shujima/thin-c-lock/README.md

## Overview / 概要

thin-C-lock is a clock style interior decoration which use thin PCB design technology developped by shujima 
thin-C-lockは shujima の薄型基板開発技術を活用して作られた時計風インテリアです。

お問合せはX(twitter) : @shjma_のDM等にお願いします。

[デザフェスtype-C-lock説明書.pdf](https://github.com/user-attachments/files/15746385/type-C-lock.1.pdf)

## Usage / 使い方


### Normal operation / 通常動作中

|Button|Function|
|-|-|
|Up button / 下ボタン| Color change / 色の変更・秒針表示の変更|
|Down button / 下ボタン| Color change / 色の変更・秒針表示の変更|
|Set button / 設定ボタン| Enter time setting mode / 時刻設定モード |

In v1.0.0 firmware, color of the hands and second display style have 7 x 3 = 21 styles.
v1.0.0のファームウェアにおいては、針の色と秒針のスタイルの設定は 7 x 3 = 21種類あります。

### Time setting mode / 時刻設定モード

時刻設定モードではまず時間（短針）の時間を変えることができます。

|Button|Function|
|-|-|
|Up button / 下ボタン| Change Time / 時刻変更|
|Down button / 下ボタン| Change Time / 時刻変更|
|Set button / 設定ボタン| To long hand setting / 長針設定へ |

長針設定モードも操作は同様です。

|Button|Function|
|-|-|
|Up button / 下ボタン| Change Time / 時刻変更|
|Down button / 下ボタン| Change Time / 時刻変更|
|Set button / 設定ボタン| Back to normal operation / 通常動作へ |

## Open source-data and usage / データの公開および利用
基板データ（BOM含む）とファームウェアを共に公開しています。
公序良俗に反しない範囲で自由にお使いいただけます。

* PCB data / 基板データ
https://github.com/shujima/thin-c-lock/releases
* USB Type-C like connector library for KiCAD / USB Type-C風コネクタ部位のみ(KiCAD用ライブラリ)
https://github.com/shujima/type-c-card/tree/master/hardware/lib_usb-type-c
* Firmware / ファームウェア
https://github.com/shujima/thin-c-lock-firmware

## Firmware update / ファームウェアアップデート

### Overview / 概要

thin-C-lock can update the firmware via Windows PC.
thin-C-lockはWindows PCを利用したファームウェアアップデートが可能です。

### Caution / 注意
* Firmware Update process is delete all internal data of thin-C-lcok and install new program file.
* If we make any misstake at this Firmware Update process, thin-C-lock may no longer work.
* Need Windows PC.
* ファームウェアアップデートはthin-C-lock内部のデータをすべて削除して、新しいプログラムファイルをインストールする作業です。
* ファームウェアアップデートの手順を間違えたりするとthin-C-lockが動作しなくなる恐れがあります。
* WindowsのPCが必要です。

### 1. ファームウェアのダウンロード

Open below link.
以下のリンクを開いてください。
[https://github.com/shujima/thin-c-lock-firmware]

Open "Releases"
"Releases"を開いてください。


Click and download the ".hex" file on the version which you want (v1.0.0 on this image).
ダウンロードしたいバージョン（この画像はv1.0.0）の欄にある".hex"で終わるファイルをクリックしてダウンロードしてください。


### 2. ファームウェア書き込みツールのインストール
Open below link (Chinese chip manufacturer).
以下のリンク（中国のチップメーカーのサイト）を開いてください。
[https://www.wch.cn/download/WCHISPTool_Setup_exe.html]

Click"下載" (means download) then it will start the download.
以下の"下載"（ダウンロードの意）をクリックしてダウンロードしてください。


インストール作業を行ってください。

### 3.  ファームウェア書き込みツールを開く
インストールしたファームウェア書き込みツール"WCHISPStudio"を開いてください。


Click ... button
「...」を押してください


Select ".hex" file downloaded on the step 1 and select "Open".
Step 1でダウンロードした「.hex」で終わるファイルを選択して「開く」を押してください。


### 4. 本体を準備する
Please remove thin-C-lock from thin-C-base and insert designated USB Type-C cable to thin-C-lock.
Do not insert to PC yet.
thin-C-lock本体をthin-C-baseから取り外して、thin-C-lockに付属のUSB Type-Cケーブルを差し込んでください。
まだPCには接続しないでください。


Do step 3 if you didn't yet, open and prepare WCHISPStudio.
まだやっていない場合は、Step 3を行って、WCHISPStudioを開いて準備しておいてください。


Insert the USB cable to your PC while pushing long the button for the Firmware Update which on near the center on thin-C-lock.
thin-C-lock本体の中央付近にあるファームウェアアップデート用ボタンを長押ししながら、USBケーブルの反対側をPCに挿入してください。


#### if successed / 成功例

All LEDs on thin-C-lock should don't lit. 
And can see green strings on WCHISPStudio.
成功するとthin-C-lockは一切LEDなどが点灯しなくなります。
またWCIHSPStudio上に緑色の文字列が表示されます。
IMG_6361 (1)


#### if failed / 失敗例

Any LED/s on thin-C-lock lit. 
文字盤を含むthin-C-lockのいずれかのLEDが点灯します。
IMG_6367 (1)

### 5. 書き込み操作をする

Re-check the configlation.
設定を再度確認します。


Click Download button.
"Download"ボタンを押します。


Re-start thin-C-lock when succeed.
You can remove USB cable and bring back thin-C-lock.
thin-C-lockが動作を再開すれば成功です。
そのままUSBケーブルを抜いてthin-C-lockを元に戻します。
