shujima/thin-c-lock/thin-c-lock_80/pcb/sub_LED.kicad_sch

## KiCad design thin-c-lock_80/pcb/sub_LED.kicad_sch (2024-05-26)

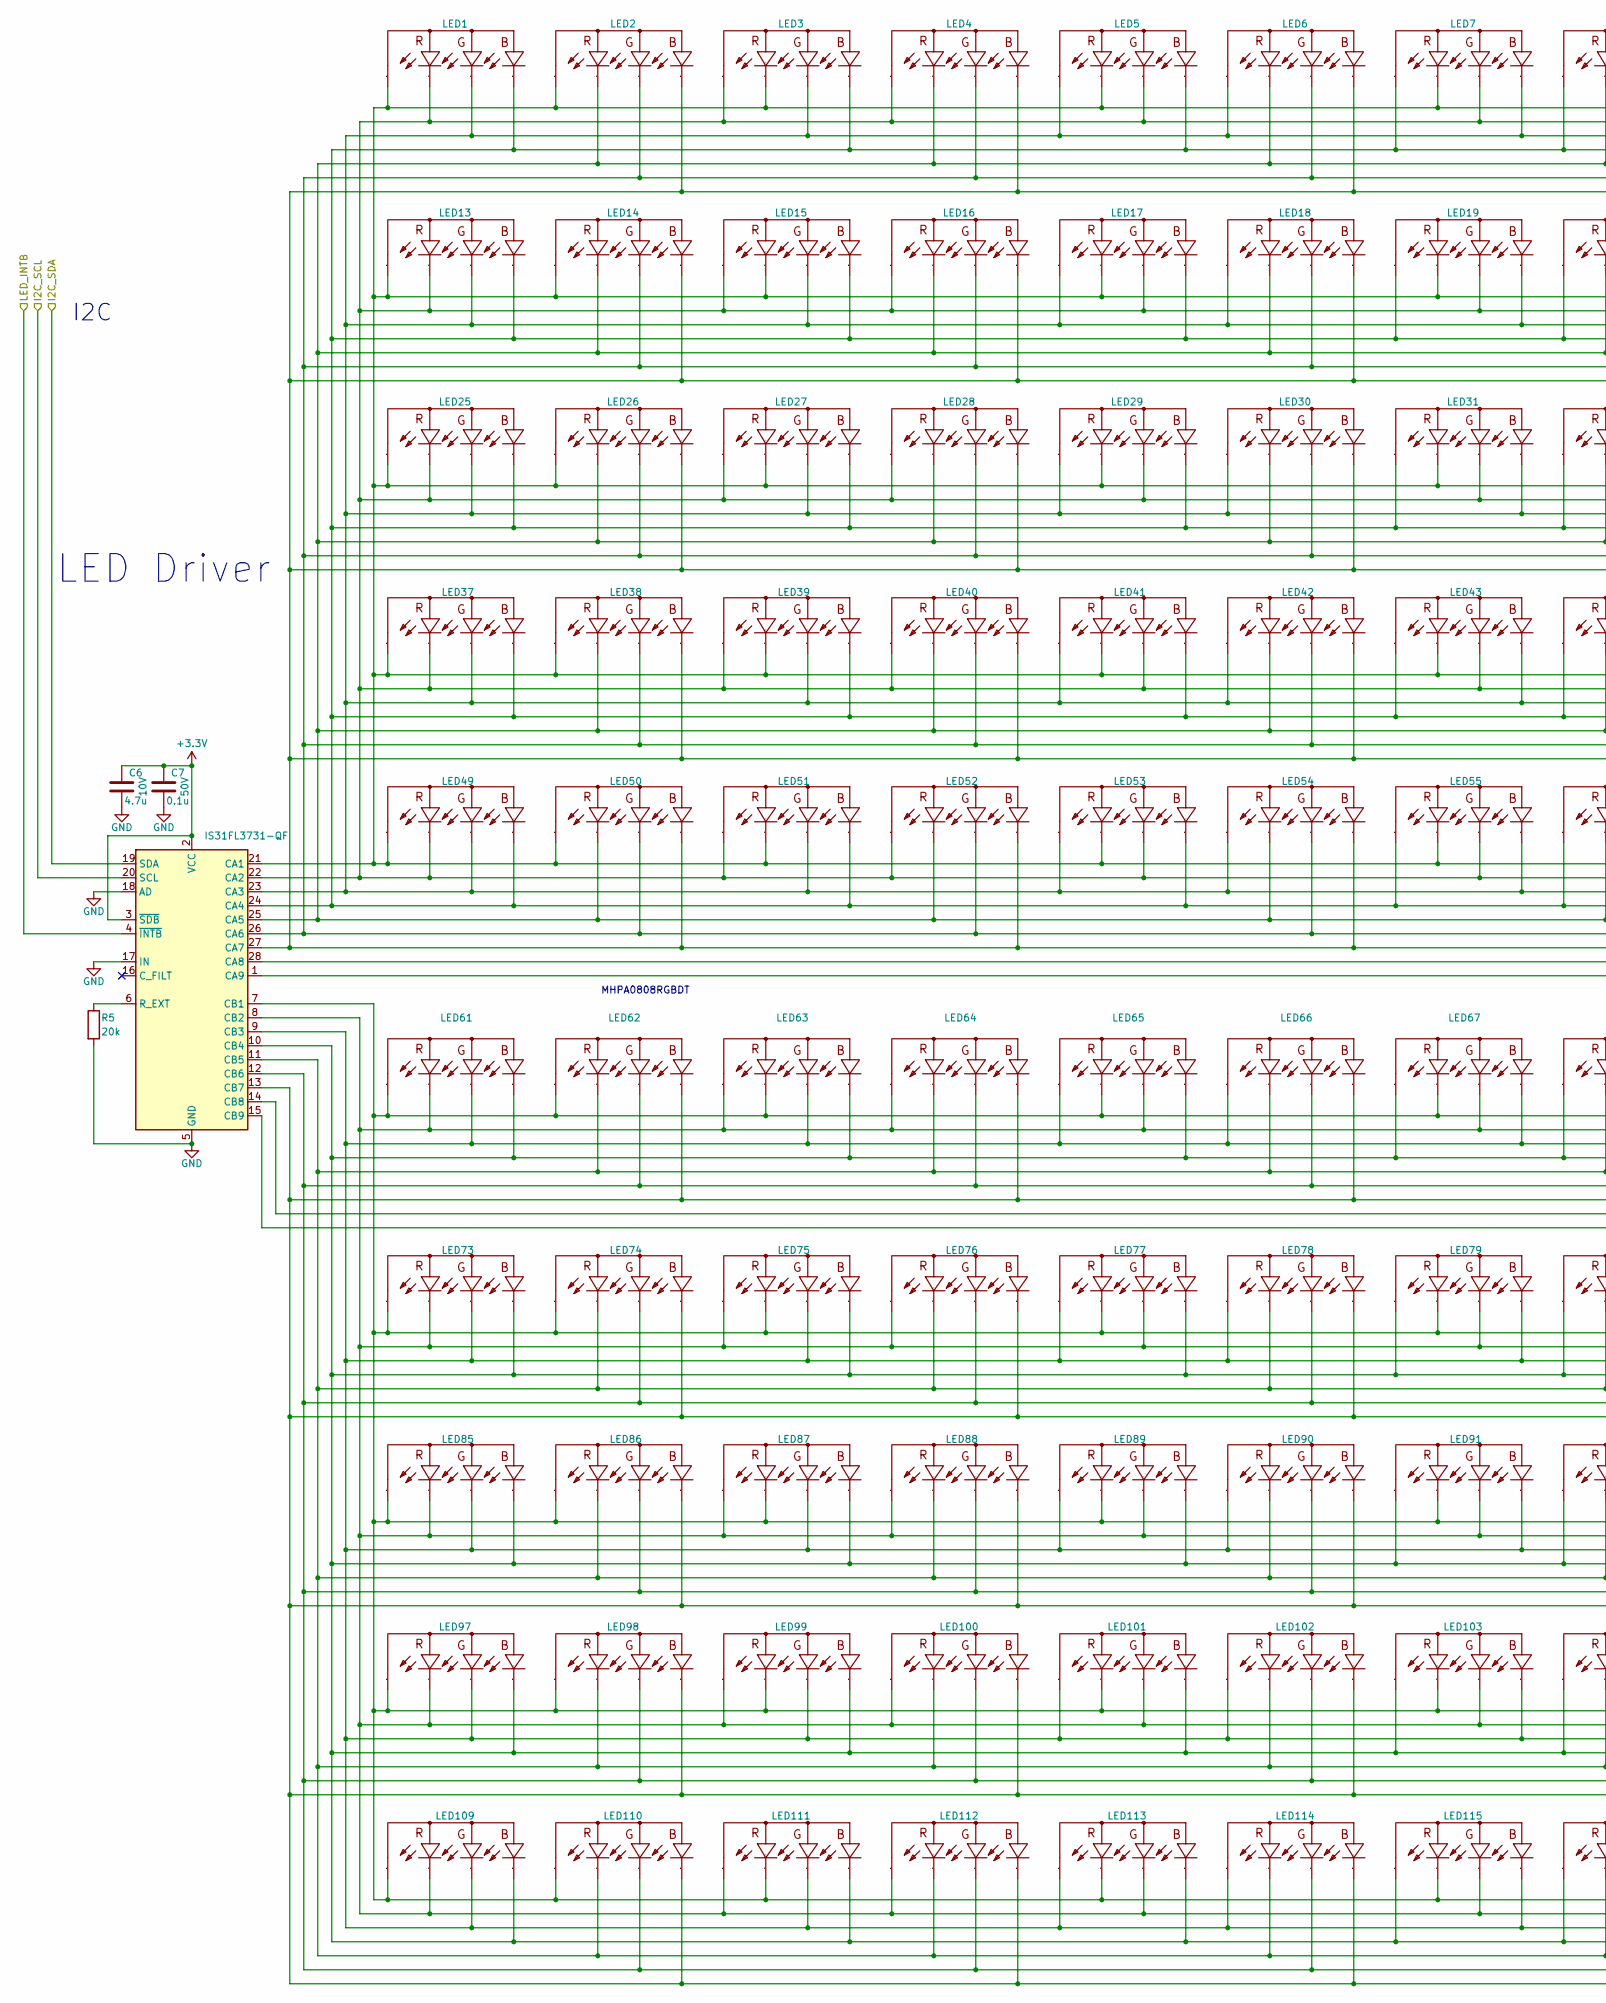
[picture p1: schematic sub_LED.kicad_sch, part in row 1, column 1]

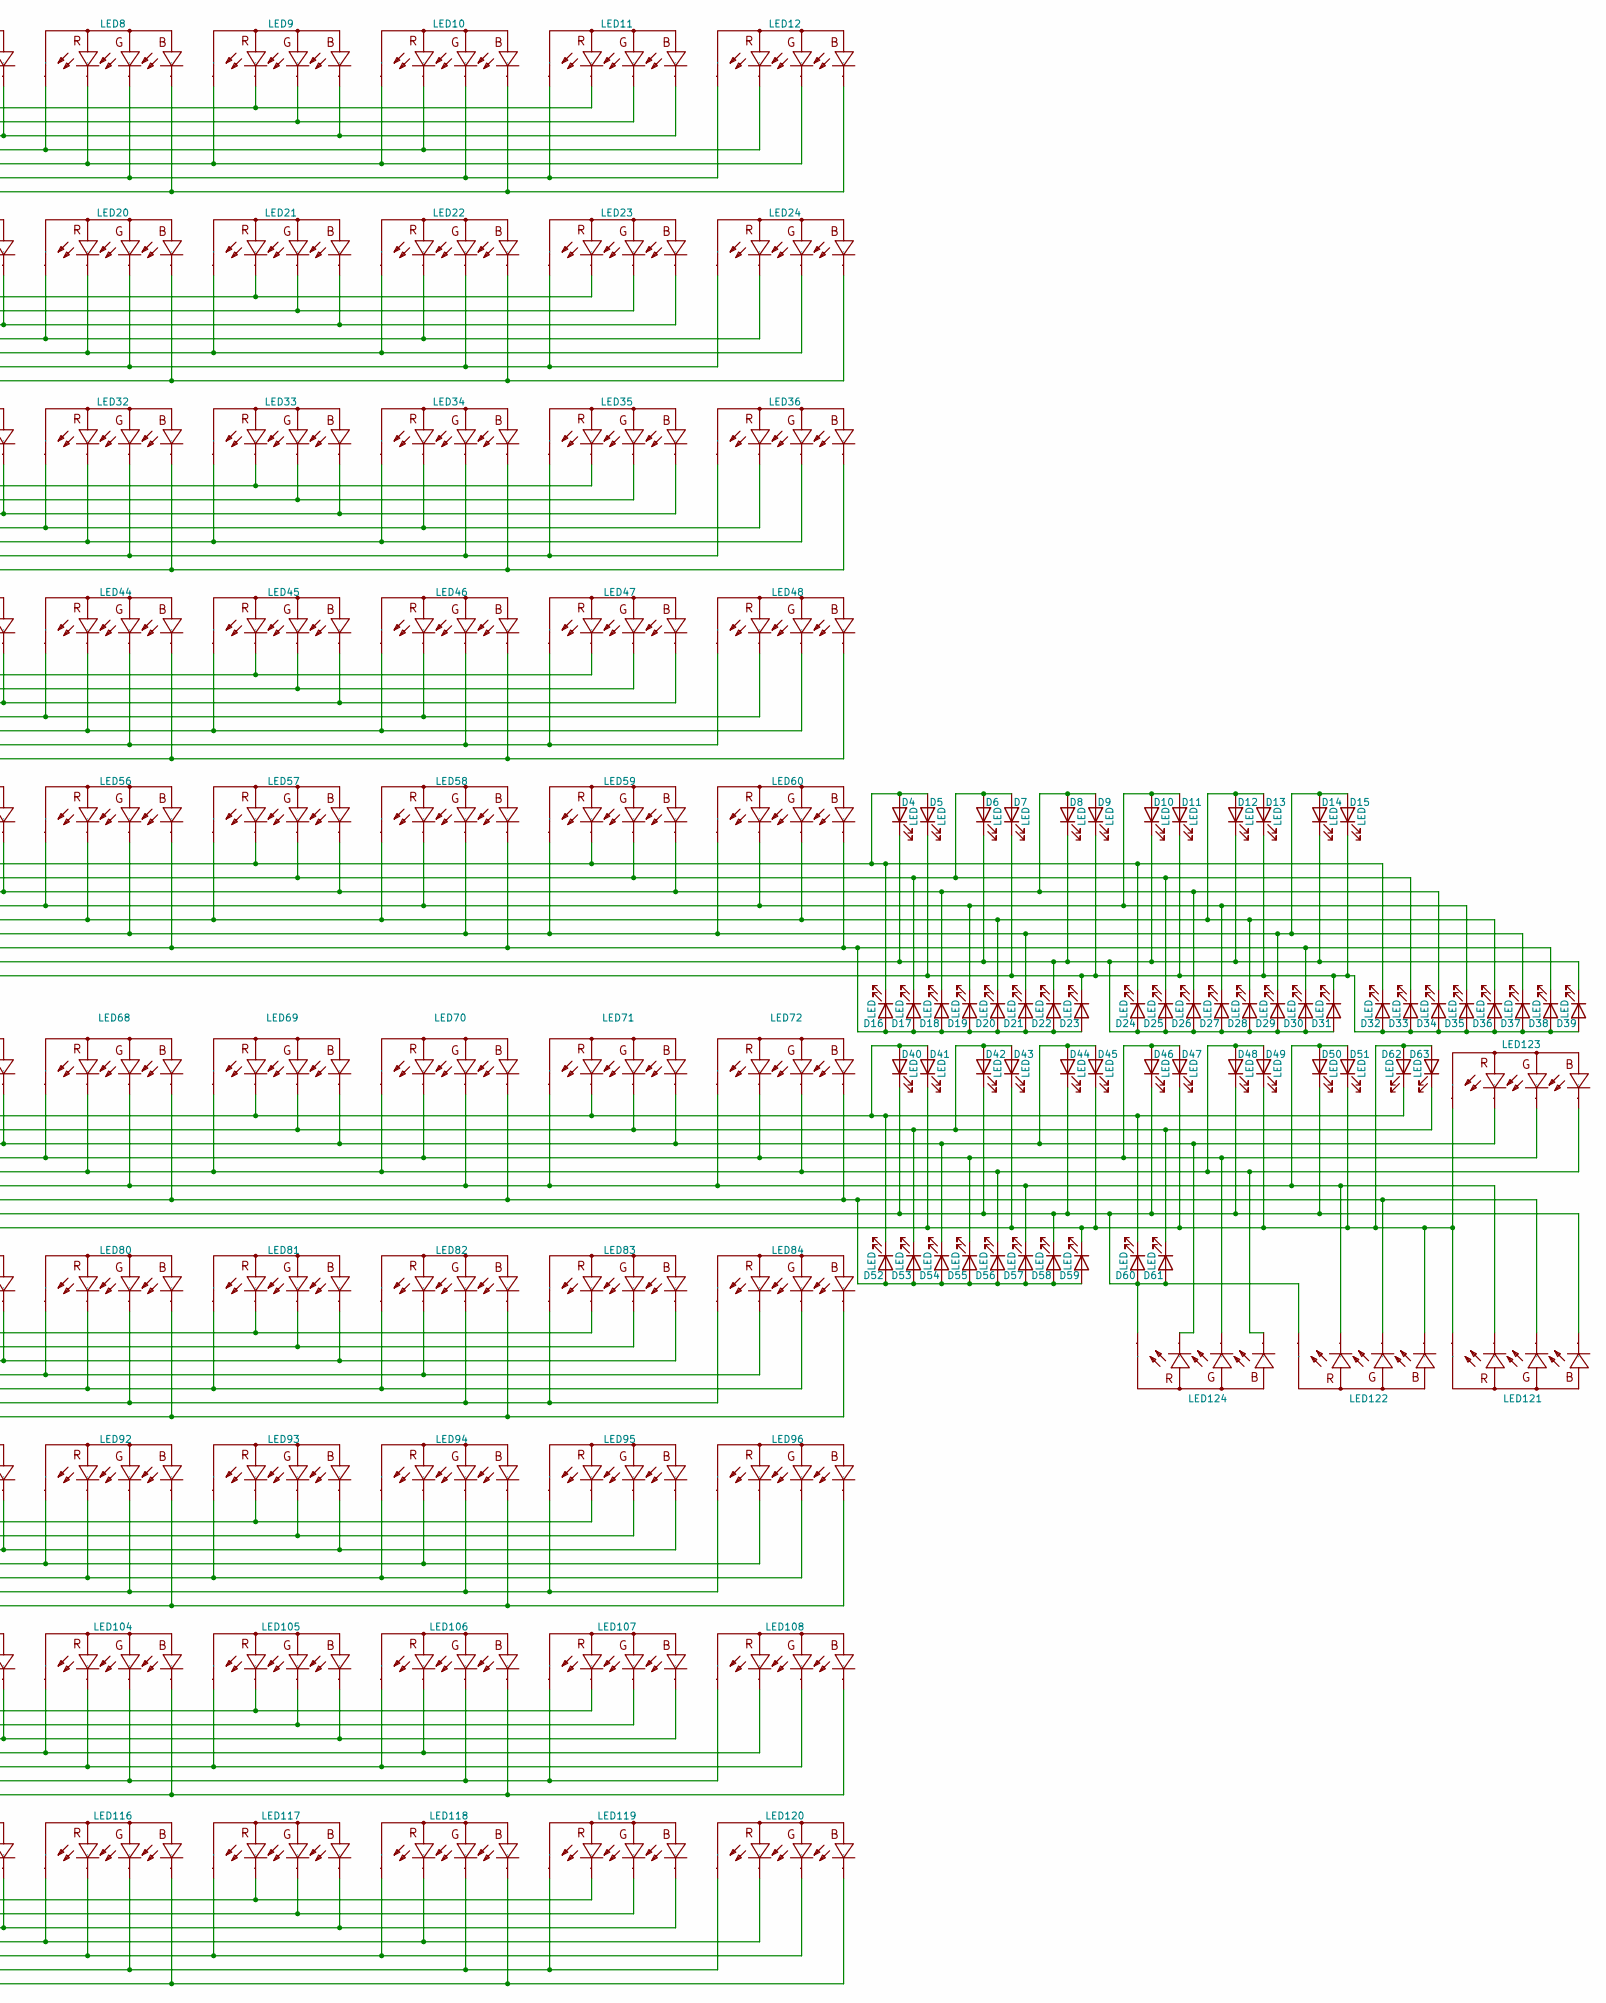
[picture p2: schematic sub_LED.kicad_sch, part in row 1, column 2]

Parts:
C6: 4.7u; C_0402_1005Metric; MPN CL05A475MP5NRNC; LCSC C23733
C7: 0.1u; C_0402_1005Metric; MPN CL05B104KB54PNC; LCSC C307331
D4, D5, D6, D7, D8, D9, D10, D11, D12, D13, D14, D15, D16, D17, D18, D19, D20, D21, D22, D23, D24, D25, D26, D27, D28, D29, D30, D31, D32, D33, D34, D35, D36, D37, D38, D39, D40, D41, D42, D43, D44, D45, D46, D47, D48, D49, D50, D51, D52, D53, D54, D55, D56, D57, D58, D59, D60, D61, D62, D63: LED; LED_0603_1608Metric; MPN KT-0603W; LCSC C2290
LED1, LED2, LED3, LED4, LED5, LED6, LED7, LED8, LED9, LED10, LED11, LED12, LED13, LED14, LED15, LED16, LED17, LED18, LED19, LED20, LED21, LED22, LED23, LED24, LED25, LED26, LED27, LED28, LED29, LED30, LED31, LED32, LED33, LED34, LED35, LED36, LED37, LED38, LED39, LED40, LED41, LED42, LED43, LED44, LED45, LED46, LED47, LED48, LED49, LED50, LED51, LED52, LED53, LED54, LED55, LED56, LED57, LED58, LED59, LED60, LED61, LED62, LED63, LED64, LED65, LED66, LED67, LED68, LED69, LED70, LED71, LED72, LED73, LED74, LED75, LED76, LED77, LED78, LED79, LED80, LED81, LED82, LED83, LED84, LED85, LED86, LED87, LED88, LED89, LED90, LED91, LED92, LED93, LED94, LED95, LED96, LED97, LED98, LED99, LED100, LED101, LED102, LED103, LED104, LED105, LED106, LED107, LED108, LED109, LED110, LED111, LED112, LED113, LED114, LED115, LED116, LED117, LED118, LED119, LED120, LED121, LED122, LED123, LED124: LED-ARRAY-SMD_4P-L0.80-W0.80-BR; MPN MHPA0808RGBDT; LCSC C404279
R5: 20k; R_0402_1005Metric; MPN 0402WGF2002TCE; LCSC C25765
U2: IS31FL3731-QF; QFN-28-1EP_4x4mm_P0.4mm_EP2.3x2.3mm; MPN IS31FL3731-QFLS2-TR; LCSC C191206

Connections:
+3.3V: C6.1, C7.1, U2.2 (VCC), U2.3 (~SDB)
GND: C6.2, C7.2, R5.2, U2.5 (GND), U2.17 (IN), U2.18 (AD), U2.29 (GND)
I2C_SCL: U2.20 (SCL)
I2C_SDA: U2.19 (SDA)
LED_INTB: U2.4 (~INTB)
unnamed: D4.1 (K), D6.1 (K), D8.1 (K), D10.1 (K), D12.1 (K), D14.1 (K), D22.1 (K), D24.2 (A), D25.2 (A), D26.2 (A), D27.2 (A), D28.2 (A), D29.2 (A), D30.2 (A), D31.2 (A), D39.1 (K), U2.28 (CA8)
unnamed: D10.2 (A), D11.2 (A), D19.1 (K), D27.1 (K), D35.1 (K), LED1.4 (-), LED3.4 (-), LED5.4 (-), LED7.1 (+), LED8.1 (+), LED10.2 (-), LED12.2 (-), LED13.4 (-), LED15.4 (-), LED17.4 (-), LED19.1 (+), LED20.1 (+), LED22.2 (-), LED24.2 (-), LED25.4 (-), LED27.4 (-), LED29.4 (-), LED31.1 (+), LED32.1 (+), LED34.2 (-), LED36.2 (-), LED37.4 (-), LED39.4 (-), LED41.4 (-), LED43.1 (+), LED44.1 (+), LED46.2 (-), LED48.2 (-), LED49.4 (-), LED51.4 (-), LED53.4 (-), LED55.1 (+), LED56.1 (+), LED58.2 (-), LED60.2 (-), U2.24 (CA4)
unnamed: D5.1 (K), D7.1 (K), D9.1 (K), D11.1 (K), D13.1 (K), D15.1 (K), D23.1 (K), D31.1 (K), D32.2 (A), D33.2 (A), D34.2 (A), D35.2 (A), D36.2 (A), D37.2 (A), D38.2 (A), D39.2 (A), U2.1 (CA9)
unnamed: D12.2 (A), D13.2 (A), D20.1 (K), D28.1 (K), D36.1 (K), LED2.2 (-), LED4.2 (-), LED6.2 (-), LED8.2 (-), LED9.1 (+), LED10.1 (+), LED12.3 (-), LED14.2 (-), LED16.2 (-), LED18.2 (-), LED20.2 (-), LED21.1 (+), LED22.1 (+), LED24.3 (-), LED26.2 (-), LED28.2 (-), LED30.2 (-), LED32.2 (-), LED33.1 (+), LED34.1 (+), LED36.3 (-), LED38.2 (-), LED40.2 (-), LED42.2 (-), LED44.2 (-), LED45.1 (+), LED46.1 (+), LED48.3 (-), LED50.2 (-), LED52.2 (-), LED54.2 (-), LED56.2 (-), LED57.1 (+), LED58.1 (+), LED60.3 (-), U2.25 (CA5)
unnamed: D14.2 (A), D15.2 (A), D21.1 (K), D29.1 (K), D37.1 (K), LED2.3 (-), LED4.3 (-), LED6.3 (-), LED8.3 (-), LED10.3 (-), LED11.1 (+), LED12.1 (+), LED14.3 (-), LED16.3 (-), LED18.3 (-), LED20.3 (-), LED22.3 (-), LED23.1 (+), LED24.1 (+), LED26.3 (-), LED28.3 (-), LED30.3 (-), LED32.3 (-), LED34.3 (-), LED35.1 (+), LED36.1 (+), LED38.3 (-), LED40.3 (-), LED42.3 (-), LED44.3 (-), LED46.3 (-), LED47.1 (+), LED48.1 (+), LED50.3 (-), LED52.3 (-), LED54.3 (-), LED56.3 (-), LED58.3 (-), LED59.1 (+), LED60.1 (+), U2.26 (CA6)
unnamed: D4.2 (A), D5.2 (A), D16.1 (K), D24.1 (K), D32.1 (K), LED1.1 (+), LED2.1 (+), LED3.2 (-), LED5.2 (-), LED7.2 (-), LED9.2 (-), LED11.2 (-), LED13.1 (+), LED14.1 (+), LED15.2 (-), LED17.2 (-), LED19.2 (-), LED21.2 (-), LED23.2 (-), LED25.1 (+), LED26.1 (+), LED27.2 (-), LED29.2 (-), LED31.2 (-), LED33.2 (-), LED35.2 (-), LED37.1 (+), LED38.1 (+), LED39.2 (-), LED41.2 (-), LED43.2 (-), LED45.2 (-), LED47.2 (-), LED49.1 (+), LED50.1 (+), LED51.2 (-), LED53.2 (-), LED55.2 (-), LED57.2 (-), LED59.2 (-), U2.21 (CA1)
unnamed: D16.2 (A), D17.2 (A), D18.2 (A), D19.2 (A), D20.2 (A), D21.2 (A), D22.2 (A), D23.2 (A), D30.1 (K), D38.1 (K), LED2.4 (-), LED4.4 (-), LED6.4 (-), LED8.4 (-), LED10.4 (-), LED12.4 (-), LED14.4 (-), LED16.4 (-), LED18.4 (-), LED20.4 (-), LED22.4 (-), LED24.4 (-), LED26.4 (-), LED28.4 (-), LED30.4 (-), LED32.4 (-), LED34.4 (-), LED36.4 (-), LED38.4 (-), LED40.4 (-), LED42.4 (-), LED44.4 (-), LED46.4 (-), LED48.4 (-), LED50.4 (-), LED52.4 (-), LED54.4 (-), LED56.4 (-), LED58.4 (-), LED60.4 (-), U2.27 (CA7)
unnamed: D6.2 (A), D7.2 (A), D17.1 (K), D25.1 (K), D33.1 (K), LED1.2 (-), LED3.1 (+), LED4.1 (+), LED5.3 (-), LED7.3 (-), LED9.3 (-), LED11.3 (-), LED13.2 (-), LED15.1 (+), LED16.1 (+), LED17.3 (-), LED19.3 (-), LED21.3 (-), LED23.3 (-), LED25.2 (-), LED27.1 (+), LED28.1 (+), LED29.3 (-), LED31.3 (-), LED33.3 (-), LED35.3 (-), LED37.2 (-), LED39.1 (+), LED40.1 (+), LED41.3 (-), LED43.3 (-), LED45.3 (-), LED47.3 (-), LED49.2 (-), LED51.1 (+), LED52.1 (+), LED53.3 (-), LED55.3 (-), LED57.3 (-), LED59.3 (-), U2.22 (CA2)
unnamed: D8.2 (A), D9.2 (A), D18.1 (K), D26.1 (K), D34.1 (K), LED1.3 (-), LED3.3 (-), LED5.1 (+), LED6.1 (+), LED7.4 (-), LED9.4 (-), LED11.4 (-), LED13.3 (-), LED15.3 (-), LED17.1 (+), LED18.1 (+), LED19.4 (-), LED21.4 (-), LED23.4 (-), LED25.3 (-), LED27.3 (-), LED29.1 (+), LED30.1 (+), LED31.4 (-), LED33.4 (-), LED35.4 (-), LED37.3 (-), LED39.3 (-), LED41.1 (+), LED42.1 (+), LED43.4 (-), LED45.4 (-), LED47.4 (-), LED49.3 (-), LED51.3 (-), LED53.1 (+), LED54.1 (+), LED55.4 (-), LED57.4 (-), LED59.4 (-), U2.23 (CA3)
unnamed: D40.1 (K), D42.1 (K), D44.1 (K), D46.1 (K), D48.1 (K), D50.1 (K), D58.1 (K), D60.2 (A), D61.2 (A), LED121.4 (-), LED122.1 (+), LED124.1 (+), U2.14 (CB8)
unnamed: D40.2 (A), D41.2 (A), D52.1 (K), D60.1 (K), D62.1 (K), LED61.1 (+), LED62.1 (+), LED63.2 (-), LED65.2 (-), LED67.2 (-), LED69.2 (-), LED71.2 (-), LED73.1 (+), LED74.1 (+), LED75.2 (-), LED77.2 (-), LED79.2 (-), LED81.2 (-), LED83.2 (-), LED85.1 (+), LED86.1 (+), LED87.2 (-), LED89.2 (-), LED91.2 (-), LED93.2 (-), LED95.2 (-), LED97.1 (+), LED98.1 (+), LED99.2 (-), LED101.2 (-), LED103.2 (-), LED105.2 (-), LED107.2 (-), LED109.1 (+), LED110.1 (+), LED111.2 (-), LED113.2 (-), LED115.2 (-), LED117.2 (-), LED119.2 (-), U2.7 (CB1)
unnamed: D41.1 (K), D43.1 (K), D45.1 (K), D47.1 (K), D49.1 (K), D51.1 (K), D59.1 (K), D62.2 (A), D63.2 (A), LED121.1 (+), LED122.4 (-), LED123.1 (+), U2.15 (CB9)
unnamed: D42.2 (A), D43.2 (A), D53.1 (K), D61.1 (K), D63.1 (K), LED61.2 (-), LED63.1 (+), LED64.1 (+), LED65.3 (-), LED67.3 (-), LED69.3 (-), LED71.3 (-), LED73.2 (-), LED75.1 (+), LED76.1 (+), LED77.3 (-), LED79.3 (-), LED81.3 (-), LED83.3 (-), LED85.2 (-), LED87.1 (+), LED88.1 (+), LED89.3 (-), LED91.3 (-), LED93.3 (-), LED95.3 (-), LED97.2 (-), LED99.1 (+), LED100.1 (+), LED101.3 (-), LED103.3 (-), LED105.3 (-), LED107.3 (-), LED109.2 (-), LED111.1 (+), LED112.1 (+), LED113.3 (-), LED115.3 (-), LED117.3 (-), LED119.3 (-), U2.8 (CB2)
unnamed: D44.2 (A), D45.2 (A), D54.1 (K), LED61.3 (-), LED63.3 (-), LED65.1 (+), LED66.1 (+), LED67.4 (-), LED69.4 (-), LED71.4 (-), LED73.3 (-), LED75.3 (-), LED77.1 (+), LED78.1 (+), LED79.4 (-), LED81.4 (-), LED83.4 (-), LED85.3 (-), LED87.3 (-), LED89.1 (+), LED90.1 (+), LED91.4 (-), LED93.4 (-), LED95.4 (-), LED97.3 (-), LED99.3 (-), LED101.1 (+), LED102.1 (+), LED103.4 (-), LED105.4 (-), LED107.4 (-), LED109.3 (-), LED111.3 (-), LED113.1 (+), LED114.1 (+), LED115.4 (-), LED117.4 (-), LED119.4 (-), LED123.2 (-), LED124.2 (-), U2.9 (CB3)
unnamed: D46.2 (A), D47.2 (A), D55.1 (K), LED61.4 (-), LED63.4 (-), LED65.4 (-), LED67.1 (+), LED68.1 (+), LED70.2 (-), LED72.2 (-), LED73.4 (-), LED75.4 (-), LED77.4 (-), LED79.1 (+), LED80.1 (+), LED82.2 (-), LED84.2 (-), LED85.4 (-), LED87.4 (-), LED89.4 (-), LED91.1 (+), LED92.1 (+), LED94.2 (-), LED96.2 (-), LED97.4 (-), LED99.4 (-), LED101.4 (-), LED103.1 (+), LED104.1 (+), LED106.2 (-), LED108.2 (-), LED109.4 (-), LED111.4 (-), LED113.4 (-), LED115.1 (+), LED116.1 (+), LED118.2 (-), LED120.2 (-), LED123.3 (-), LED124.3 (-), U2.10 (CB4)
unnamed: D48.2 (A), D49.2 (A), D56.1 (K), LED62.2 (-), LED64.2 (-), LED66.2 (-), LED68.2 (-), LED69.1 (+), LED70.1 (+), LED72.3 (-), LED74.2 (-), LED76.2 (-), LED78.2 (-), LED80.2 (-), LED81.1 (+), LED82.1 (+), LED84.3 (-), LED86.2 (-), LED88.2 (-), LED90.2 (-), LED92.2 (-), LED93.1 (+), LED94.1 (+), LED96.3 (-), LED98.2 (-), LED100.2 (-), LED102.2 (-), LED104.2 (-), LED105.1 (+), LED106.1 (+), LED108.3 (-), LED110.2 (-), LED112.2 (-), LED114.2 (-), LED116.2 (-), LED117.1 (+), LED118.1 (+), LED120.3 (-), LED123.4 (-), LED124.4 (-), U2.11 (CB5)
unnamed: D50.2 (A), D51.2 (A), D57.1 (K), LED62.3 (-), LED64.3 (-), LED66.3 (-), LED68.3 (-), LED70.3 (-), LED71.1 (+), LED72.1 (+), LED74.3 (-), LED76.3 (-), LED78.3 (-), LED80.3 (-), LED82.3 (-), LED83.1 (+), LED84.1 (+), LED86.3 (-), LED88.3 (-), LED90.3 (-), LED92.3 (-), LED94.3 (-), LED95.1 (+), LED96.1 (+), LED98.3 (-), LED100.3 (-), LED102.3 (-), LED104.3 (-), LED106.3 (-), LED107.1 (+), LED108.1 (+), LED110.3 (-), LED112.3 (-), LED114.3 (-), LED116.3 (-), LED118.3 (-), LED119.1 (+), LED120.1 (+), LED121.2 (-), LED122.2 (-), U2.12 (CB6)
unnamed: D52.2 (A), D53.2 (A), D54.2 (A), D55.2 (A), D56.2 (A), D57.2 (A), D58.2 (A), D59.2 (A), LED62.4 (-), LED64.4 (-), LED66.4 (-), LED68.4 (-), LED70.4 (-), LED72.4 (-), LED74.4 (-), LED76.4 (-), LED78.4 (-), LED80.4 (-), LED82.4 (-), LED84.4 (-), LED86.4 (-), LED88.4 (-), LED90.4 (-), LED92.4 (-), LED94.4 (-), LED96.4 (-), LED98.4 (-), LED100.4 (-), LED102.4 (-), LED104.4 (-), LED106.4 (-), LED108.4 (-), LED110.4 (-), LED112.4 (-), LED114.4 (-), LED116.4 (-), LED118.4 (-), LED120.4 (-), LED121.3 (-), LED122.3 (-), U2.13 (CB7)
unnamed: R5.1, U2.6 (R_EXT)

Notes on the sheet:
I2C
MHPA0808RGBDT
LED Driver
