shujima/thin-c-lock/thin-c-lock_80/pcb/thin-c-lock_80.kicad_sch

## KiCad design thin-c-lock_80/pcb/thin-c-lock_80.kicad_sch (2024-05-26)

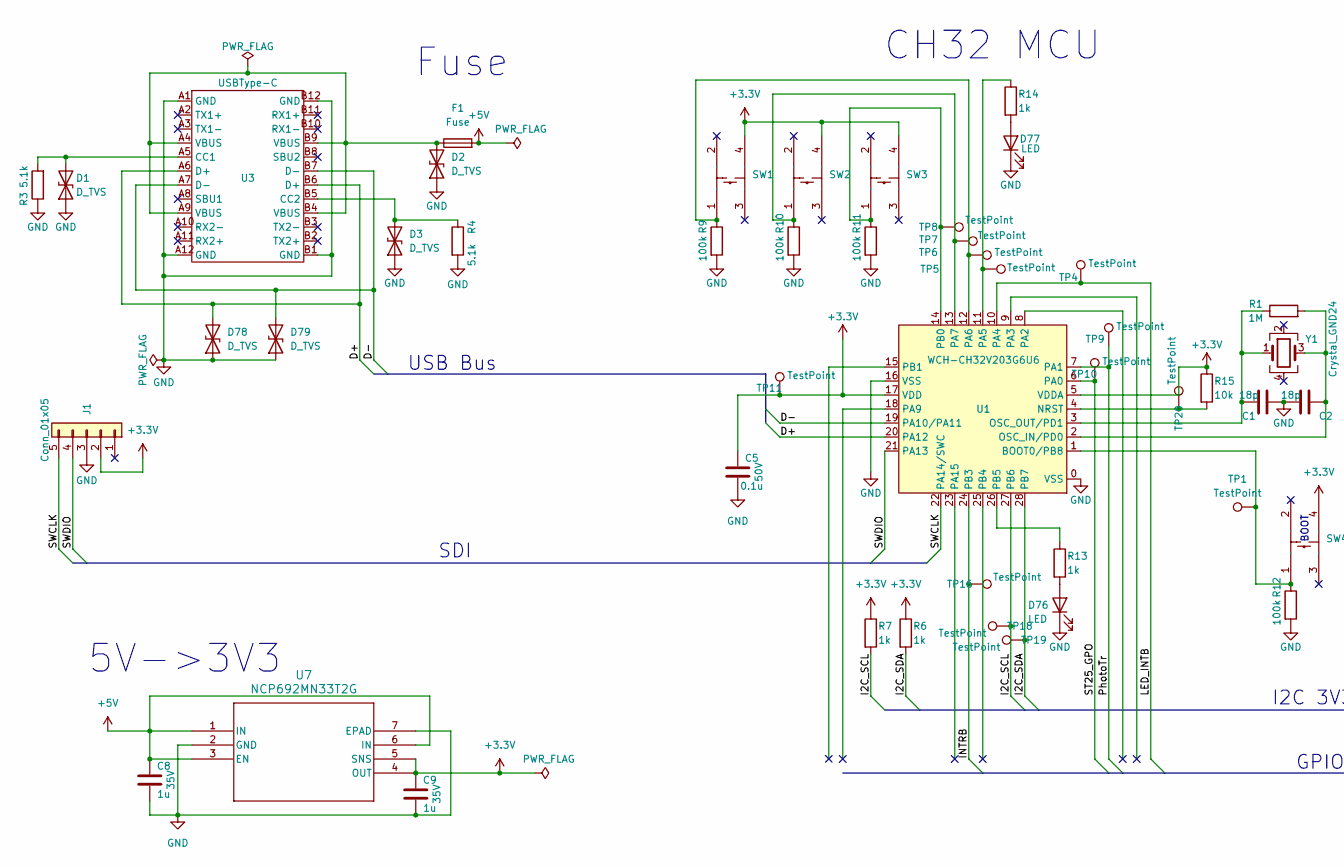
[picture p3: schematic thin-c-lock_80.kicad_sch, part in row 1, column 1]

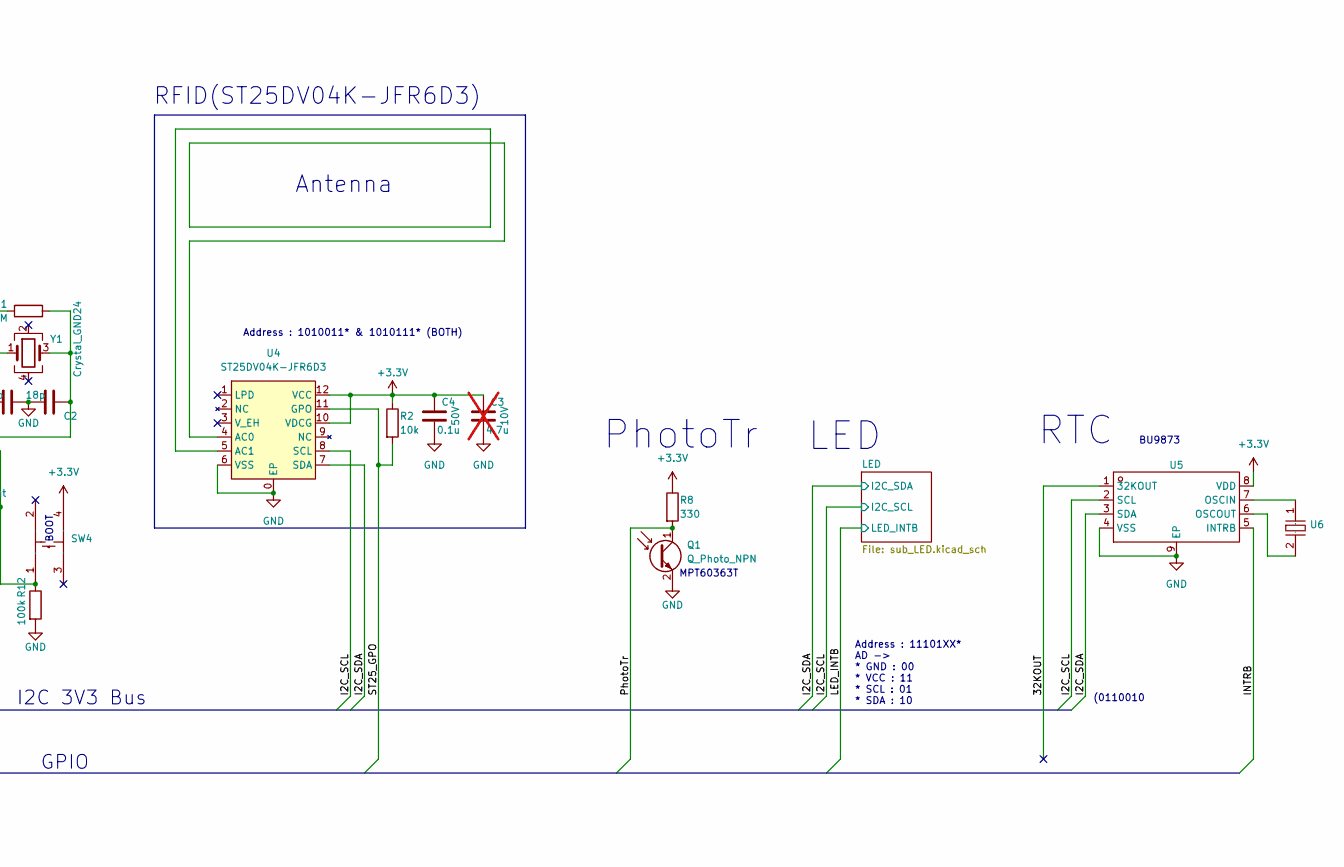
[picture p4: schematic thin-c-lock_80.kicad_sch, part in row 1, column 2]

Parts:
C1, C2: 18p; C_0402_1005Metric; MPN GRM1555C1H180JA01D; LCSC C33149
C3: 4.7u; C_0402_1005Metric; MPN CL05A475MP5NRNC; LCSC C23733; not fitted
C4, C5: 0.1u; C_0402_1005Metric; MPN CL05B104KB54PNC; LCSC C307331
C8, C9: 1u; C_0402_1005Metric; MPN CL05A105KL5NRNC; LCSC C307413
D1, D2, D3, D78, D79: D_TVS; Fuse_0402_1005Metric; MPN BPESD0402-05ST; LCSC C316059
D76, D77: LED; LED_0603_1608Metric; MPN KT-0603W; LCSC C2290
F1: Fuse; Fuse_1206_3216Metric; MPN FTR1206-110; LCSC C882994
J1: Conn_01x05; PinHeader_1x05_P2.54mm_Vertical_Nosilk
Q1: Q_Photo_NPN; MPT6036T; MPN MPT60363T; LCSC C50493
R1: 1M; R_0402_1005Metric; MPN 0402WGF1004TCE; LCSC C26083
R2, R15: 10k; R_0402_1005Metric; MPN 0402WGF1002TCE; LCSC C25744
R3, R4: 5.1k; R_0402_1005Metric; MPN 0402WGF5101TCE; LCSC C25905
R6, R7, R13, R14: 1k; R_0402_1005Metric; MPN 0402WGF1001TCE; LCSC C11702
R8: 330; R_0402_1005Metric; MPN 0402WGF3300TCE
R9, R10, R11, R12: 100k; R_0402_1005Metric; MPN 0402WGF1003TCE; LCSC C25741
SW1, SW2, SW3, SW4: KEY-SMD_4P-L4.8-W4.8-P3.70-LS6.4-TL; MPN TS-1087SM-26; LCSC C455275
TP1, TP4, TP5, TP6, TP7, TP8, TP9, TP10, TP11, TP16, TP18, TP19, TP20: TestPoint; TestPoint_Pad_D1.0mm
U1: WCH-CH32V203G6U6; MPN CH32V203G6U6; LCSC C5142280
U3: USBType-C
U4: ST25DV04K-JFR6D3; MPN ST25DV04K-JFR6D3; LCSC C2654815
U5: DFN-8_L3.0-W2.0-P0.50-BL-EP1.6; MPN BU9873NUX-TTR; LCSC C2672590
U6: CRYSTAL-SMD_L1.6-W1.0; MPN CM9V-T1A-32.768KHZ-9PF-20PPM-TA-QC; LCSC C5366547
U7: NCP692MN33T2G; DFN6_3X3_ONS; MPN NCP692MN33T2G; LCSC C145519
Y1: Crystal_GND24; Seiko-Epson-X1E0002510046; MPN R824000012; LCSC C2929397

Connections:
32KOUT: U5.1 (32KOUT)
+3.3V: C3.1, C4.1, C5.1, C9.1, J1.2, R2.1, R6.1, R7.1, R8.1, R15.1, SW1.4, SW2.4, SW3.4, SW4.4, TP11.1, U1.5 (VDDA), U1.17 (VDD), U4.10 (VDCG), U4.12 (VCC), U5.8 (VDD), U7.4 (OUT), U7.5 (SNS)
+5V: C8.1, F1.2, U7.1 (IN), U7.3 (EN), U7.6 (IN)
D+: D78.2 (A2), U1.20 (PA12), U3.A6 (D+), U3.B6 (D+)
D-: D79.2 (A2), U1.19 (PA10/PA11), U3.A7 (D-), U3.B7 (D-)
GND: C1.2, C2.1, C3.2, C4.2, C5.2, C8.2, C9.2, D1.1 (A1), D2.1 (A1), D3.1 (A1), D76.1 (K), D77.1 (K), D78.1 (A1), D79.1 (A1), J1.3, Q1.2 (E), R3.1, R4.2, R9.2, R10.2, R11.2, R12.2, U1.0 (VSS), U1.16 (VSS), U3.A1 (GND), U3.A12 (GND), U3.B1 (GND), U3.B12 (GND), U4.0 (EP), U4.6 (VSS), U5.4 (VSS), U5.9 (EP), U7.2 (GND), U7.7 (EPAD)
I2C_SCL: R7.2, TP18.1, U1.27 (PB6), U4.8 (SCL), U5.2 (SCL)
I2C_SDA: R6.2, TP19.1, U1.28 (PB7), U4.7 (SDA), U5.3 (SDA)
INTRB: TP16.1, U1.24 (PB3), U5.5 (INTRB)
LED_INTB: TP4.1, U1.10 (PA4)
unnamed: C1.1, R1.1, U1.3 (OSC_OUT/PD1), Y1.1
unnamed: C2.2, R1.2, U1.2 (OSC_IN/PD0), Y1.3
unnamed: D1.2 (A2), R3.2, U3.A5 (CC1)
unnamed: D2.2 (A2), F1.1, U3.A4 (VBUS), U3.A9 (VBUS), U3.B4 (VBUS), U3.B9 (VBUS)
unnamed: D3.2 (A2), R4.1, U3.B5 (CC2)
unnamed: D76.2 (A), R13.2
unnamed: D77.2 (A), R14.2
unnamed: R9.1, SW1.1, TP6.1, U1.12 (PA6)
unnamed: R10.1, SW2.1, TP7.1, U1.13 (PA7)
unnamed: R11.1, SW3.1, TP8.1, U1.14 (PB0)
unnamed: R12.1, SW4.1, TP1.1, U1.1 (BOOT0/PB8)
unnamed: R13.1, U1.26 (PB5)
unnamed: R14.1, TP5.1, U1.11 (PA5)
unnamed: R15.2, TP20.1, U1.4 (NRST)
unnamed: U4.4 (AC0), U4.5 (AC1)
unnamed: U5.6 (OSCOUT), U6.2
unnamed: U5.7 (OSCIN), U6.1
PhotoTr: Q1.1 (C), R8.2, TP9.1, U1.7 (PA1)
ST25_GPO: R2.2, TP10.1, U1.6 (PA0), U4.11 (GPO)
SWCLK: J1.5, U1.22 (PA14/SWC)
SWDIO: J1.4, U1.21 (PA13)

Notes on the sheet:
Address : 11101XX* AD -> * GND : 00 * VCC : 11 * SCL : 01 * SDA : 10
PhotoTr
MPT60363T
GPIO
RFID(ST25DV04K-JFR6D3)
(0110010
USB Bus
RTC
Fuse
BU9873
BOOT
5V->3V3
Antenna
CH32 MCU
SDI
LED
I2C 3V3 Bus
Address : 1010011* & 1010111* (BOTH)
